TheContrappostoShop/PICOre/KiCad_Lib/stamp_RP2040_3D.step

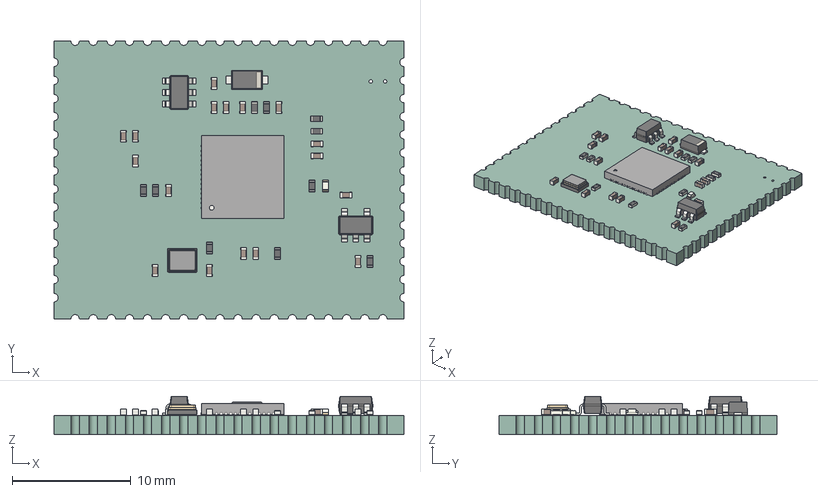
[picture p2: CAD file, 2025-01-04]
KiCad_Lib/stamp_RP2040_3D.step
29.5 x 23.4 x 3.20 mm
C_0402_1005Metric x 17
SOT_23_6
QFN_56_1EP_7x7mm_P04mm_EP32x32mm
R_0402_1005Metric x 10
LED_0402_1005Metric
D_SOD_123F
Crystal_SMD_2520-4Pin_2.5x2.0mm
SOT_23_5
stamp_RP2040_PCB
