TheContrappostoShop/PICOre/(list of files, cad)

Other CAD files:
V.RP2040/KiCad_File/stamp_RP2040.step
