TheContrappostoShop/PICOre/V.RP2040/KiCad_File/stamp_RP2040.kicad_sch

## KiCad design V.RP2040/KiCad_File/stamp_RP2040.kicad_sch (2025-02-10)

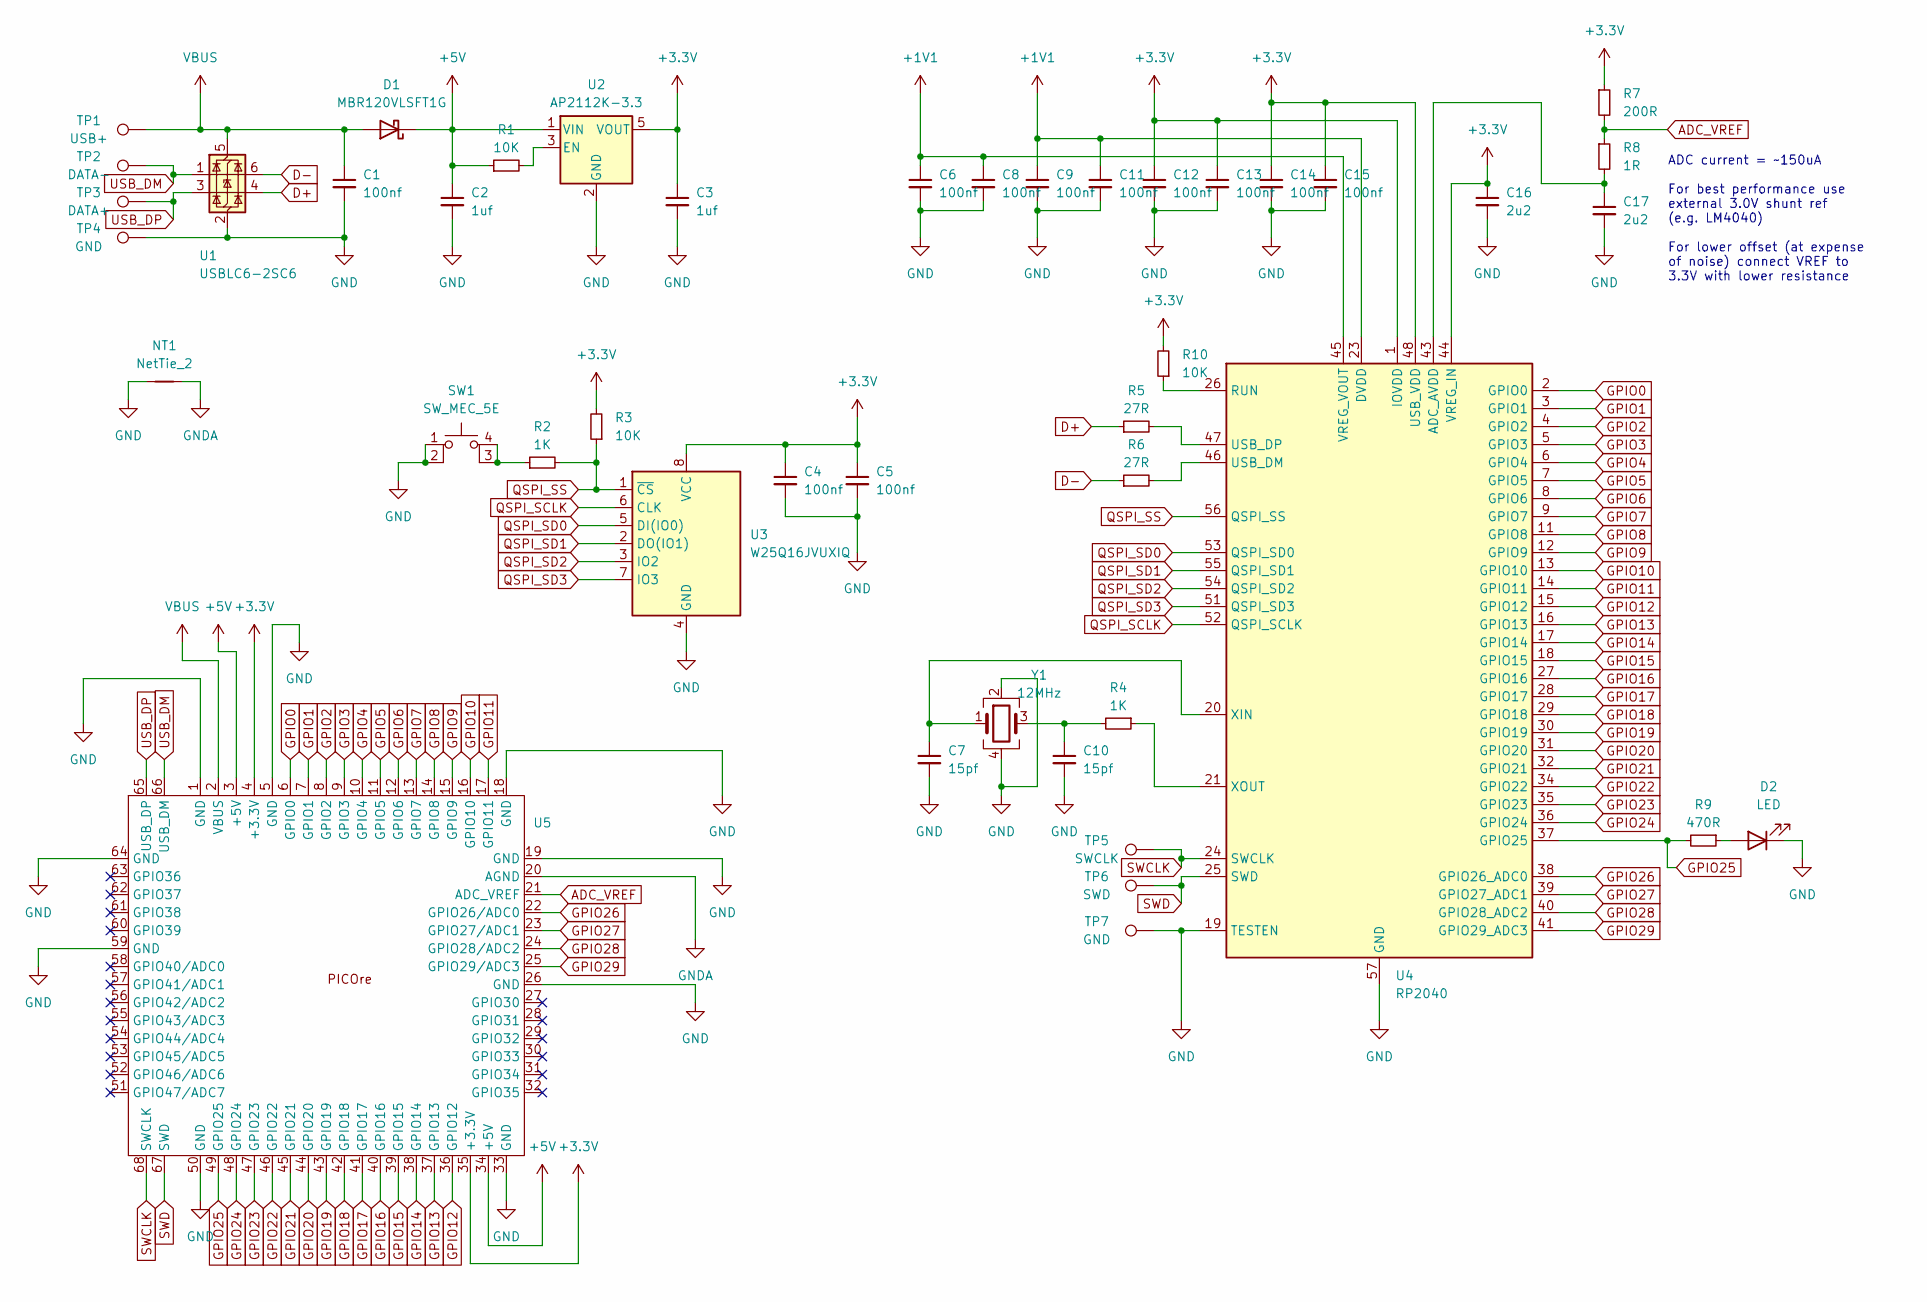
[picture p3: schematic stamp_RP2040.kicad_sch]

Parts:
C1, C4, C5, C6, C8, C9, C11, C12, C13, C14, C15: 100nf; C_0402_1005Metric
C2, C3: 1uf; C_0402_1005Metric
C7, C10: 15pf; C_0402_1005Metric
C16, C17: 2u2; C_0402_1005Metric
D1: MBR120VLSFT1G; D_SOD-123F
D2: LED; LED_0402_1005Metric
NT1: NetTie_2; NetTie-2_THT_Pad0.3mm
R1, R3, R10: 10K; R_0402_1005Metric
R2, R4: 1K; R_0402_1005Metric
R5, R6: 27R; R_0402_1005Metric
R7: 200R; R_0402_1005Metric
R8: 1R; R_0402_1005Metric
R9: 470R; R_0402_1005Metric
SW1: SW_MEC_5E; SW_Push_1P1T_NO_Vertical_Wuerth_434133025816
TP1: USB+; TestPoint_Pad_D1.0mm
TP2: DATA-; TestPoint_Pad_D1.0mm
TP3: DATA+; TestPoint_Pad_D1.0mm
TP4, TP7: GND; TestPoint_Pad_D1.0mm
TP5: SWCLK; TestPoint_Pad_D1.0mm
TP6: SWD; TestPoint_Pad_D1.0mm
U1: USBLC6-2SC6; SOT-23-6
U2: AP2112K-3.3; SOT-23-5
U3: W25Q16JVUXIQ
U4: RP2040; QFN-56-1EP_7x7mm_P0.4mm_EP3.2x3.2mm
U5: PICOre_Stamp
Y1: 12MHz; Crystal_SMD_2520-4Pin_2.5x2.0mm

Connections:
+1V1: C6.1, C8.1, C9.1, C11.1, U4.23 (DVDD), U4.45 (VREG_VOUT), U4.50 (DVDD)
+3.3V: C3.1, C4.1, C5.1, C12.1, C13.1, C14.1, C15.1, C16.1, R3.2, R7.1, R10.2, U2.5 (VOUT), U3.8 (VCC), U4.1 (IOVDD), U4.10 (IOVDD), U4.22 (IOVDD), U4.33 (IOVDD), U4.42 (IOVDD), U4.44 (VREG_IN), U4.48 (USB_VDD), U4.49 (IOVDD), U5.4 (+3.3V), U5.35 (+3.3V)
+5V: C2.1, D1.1 (K), R1.1, U2.1 (VIN), U5.3 (+5V), U5.34 (+5V)
ADC_VREF: R7.2, R8.1, U5.21 (ADC_VREF)
D+: R5.1, U1.4 (I/O2)
D-: R6.1, U1.6 (I/O1)
GND: C1.2, C2.2, C3.2, C4.2, C5.2, C6.2, C7.2, C8.2, C9.2, C10.2, C11.2, C12.2, C13.2, C14.2, C15.2, C16.2, C17.2, D2.1 (K), NT1.1, SW1.1, SW1.2, TP4.1, TP7.1, U1.2 (GND), U2.2 (GND), U3.4 (GND), U4.19 (TESTEN), U4.57 (GND), U5.1 (GND), U5.5 (GND), U5.18 (GND), U5.19 (GND), U5.26 (GND), U5.33 (GND), U5.50 (GND), U5.59 (GND), U5.64 (GND), Y1.2, Y1.4
GNDA: NT1.2, U5.20 (AGND)
GPIO0: U4.2 (GPIO0), U5.6 (GPIO0)
GPIO1: U4.3 (GPIO1), U5.7 (GPIO1)
GPIO2: U4.4 (GPIO2), U5.8 (GPIO2)
GPIO3: U4.5 (GPIO3), U5.9 (GPIO3)
GPIO4: U4.6 (GPIO4), U5.10 (GPIO4)
GPIO5: U4.7 (GPIO5), U5.11 (GPIO5)
GPIO6: U4.8 (GPIO6), U5.12 (GPIO6)
GPIO7: U4.9 (GPIO7), U5.13 (GPIO7)
GPIO8: U4.11 (GPIO8), U5.14 (GPIO8)
GPIO9: U4.12 (GPIO9), U5.15 (GPIO9)
GPIO10: U4.13 (GPIO10), U5.16 (GPIO10)
GPIO11: U4.14 (GPIO11), U5.17 (GPIO11)
GPIO12: U4.15 (GPIO12), U5.36 (GPIO12)
GPIO13: U4.16 (GPIO13), U5.37 (GPIO13)
GPIO14: U4.17 (GPIO14), U5.38 (GPIO14)
GPIO15: U4.18 (GPIO15), U5.39 (GPIO15)
GPIO16: U4.27 (GPIO16), U5.40 (GPIO16)
GPIO17: U4.28 (GPIO17), U5.41 (GPIO17)
GPIO18: U4.29 (GPIO18), U5.42 (GPIO18)
GPIO19: U4.30 (GPIO19), U5.43 (GPIO19)
GPIO20: U4.31 (GPIO20), U5.44 (GPIO20)
GPIO21: U4.32 (GPIO21), U5.45 (GPIO21)
GPIO22: U4.34 (GPIO22), U5.46 (GPIO22)
GPIO23: U4.35 (GPIO23), U5.47 (GPIO23)
GPIO24: U4.36 (GPIO24), U5.48 (GPIO24)
GPIO25: R9.2, U4.37 (GPIO25), U5.49 (GPIO25)
GPIO26: U4.38 (GPIO26_ADC0), U5.22 (GPIO26/ADC0)
GPIO27: U4.39 (GPIO27_ADC1), U5.23 (GPIO27/ADC1)
GPIO28: U4.40 (GPIO28_ADC2), U5.24 (GPIO28/ADC2)
GPIO29: U4.41 (GPIO29_ADC3), U5.25 (GPIO29/ADC3)
unnamed: C7.1, U4.20 (XIN), Y1.1
unnamed: C10.1, R4.2, Y1.3
unnamed: C17.1, R8.2, U4.43 (ADC_AVDD)
unnamed: D2.2 (A), R9.1
unnamed: R1.2, U2.3 (EN)
unnamed: R2.1, SW1.3 (K), SW1.4 (A)
unnamed: R4.1, U4.21 (XOUT)
unnamed: R5.2, U4.47 (USB_DP)
unnamed: R6.2, U4.46 (USB_DM)
unnamed: R10.1, U4.26 (RUN)
QSPI_SCLK: U3.6 (CLK), U4.52 (QSPI_SCLK)
QSPI_SD0: U3.5 (DI(IO0)), U4.53 (QSPI_SD0)
QSPI_SD1: U3.2 (DO(IO1)), U4.55 (QSPI_SD1)
QSPI_SD2: U3.3 (IO2), U4.54 (QSPI_SD2)
QSPI_SD3: U3.7 (IO3), U4.51 (QSPI_SD3)
QSPI_SS: R2.2, R3.1, U3.1 (~CS), U4.56 (QSPI_SS)
SWCLK: TP5.1, U4.24 (SWCLK), U5.68 (SWCLK)
SWD: TP6.1, U4.25 (SWD), U5.67 (SWD)
USB_DM: TP2.1, U1.1 (I/O1), U5.66 (USB_DM)
USB_DP: TP3.1, U1.3 (I/O2), U5.65 (USB_DP)
VBUS: C1.1, D1.2 (A), TP1.1, U1.5 (VBUS), U5.2 (VBUS)

Notes on the sheet:
ADC current = ~150uA For best performance use external 3.0V shunt ref (e.g. LM4040) For lower offset (at expense of noise) connect VREF to 3.3V with lower resistance
